mentako-ya/magictrackrest-qmk/mtr/mtr_image/key_image1.jpg

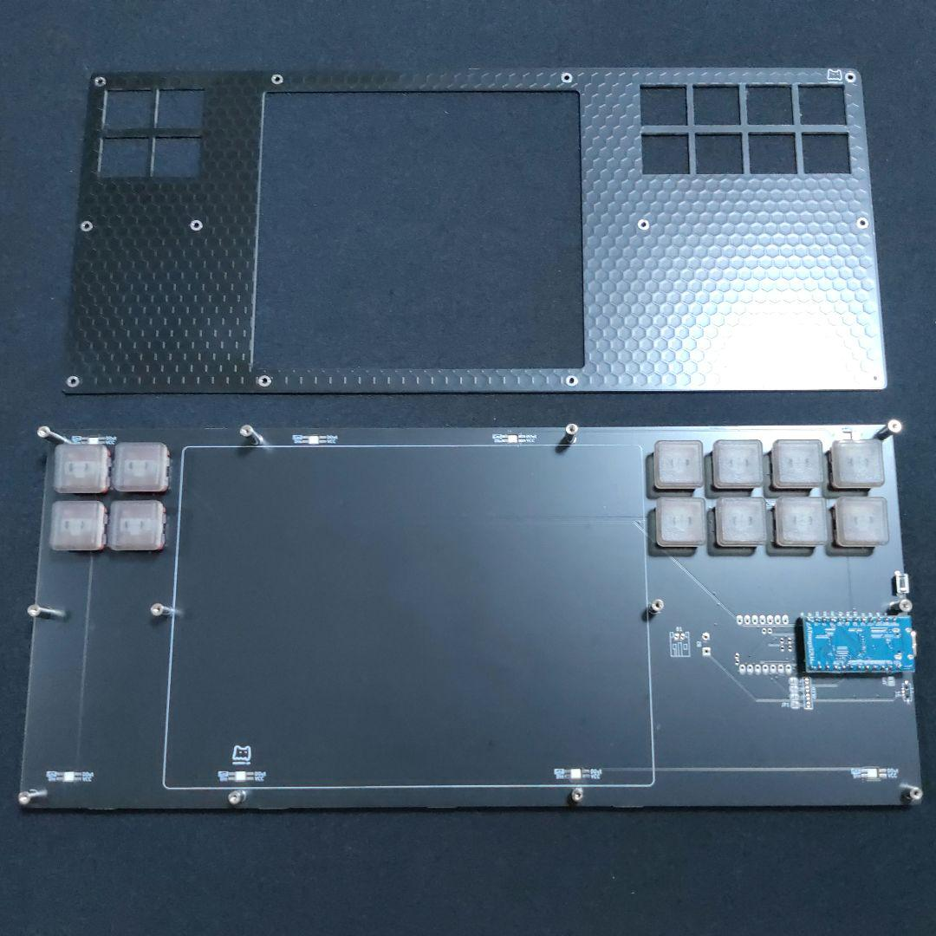
mtr/mtr_image/key_image1.jpg
