mentako-ya/magictrackrest-qmk/mtr/mtr_image/key_image2.jpg

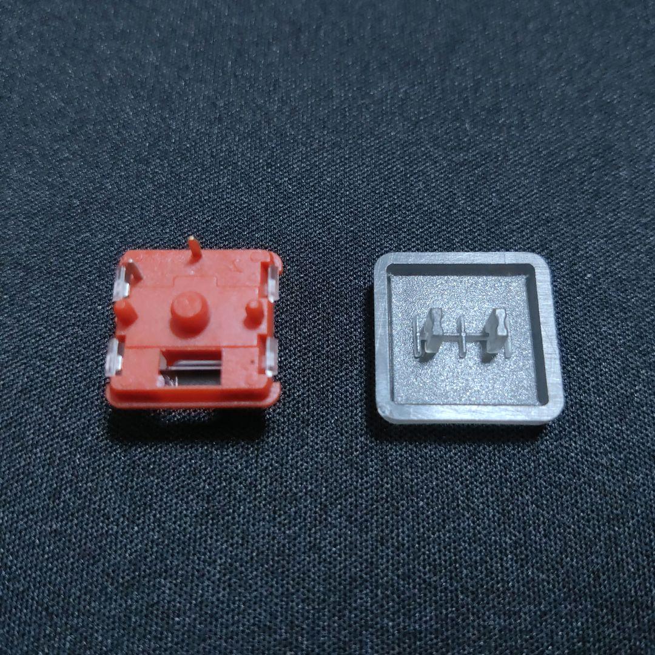
mtr/mtr_image/key_image2.jpg
