mentako-ya/magictrackrest-qmk/mtr/mtr_image/key_image3.jpg

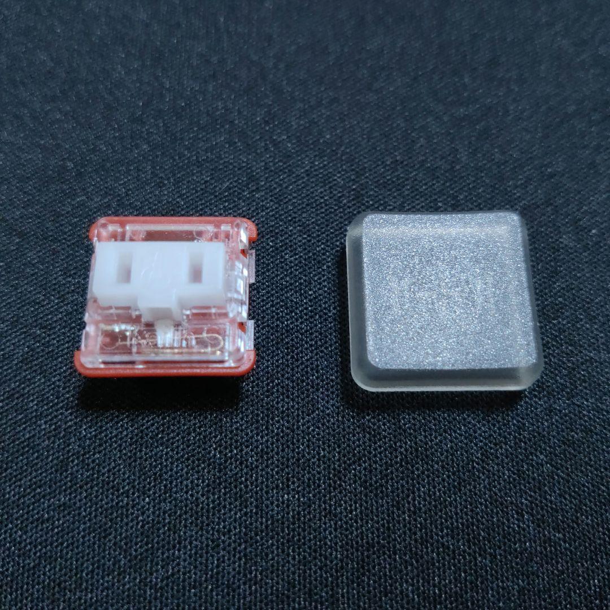
mtr/mtr_image/key_image3.jpg
