mentako-ya/magictrackrest-qmk/mtr/mtr_image/key_image4.jpg

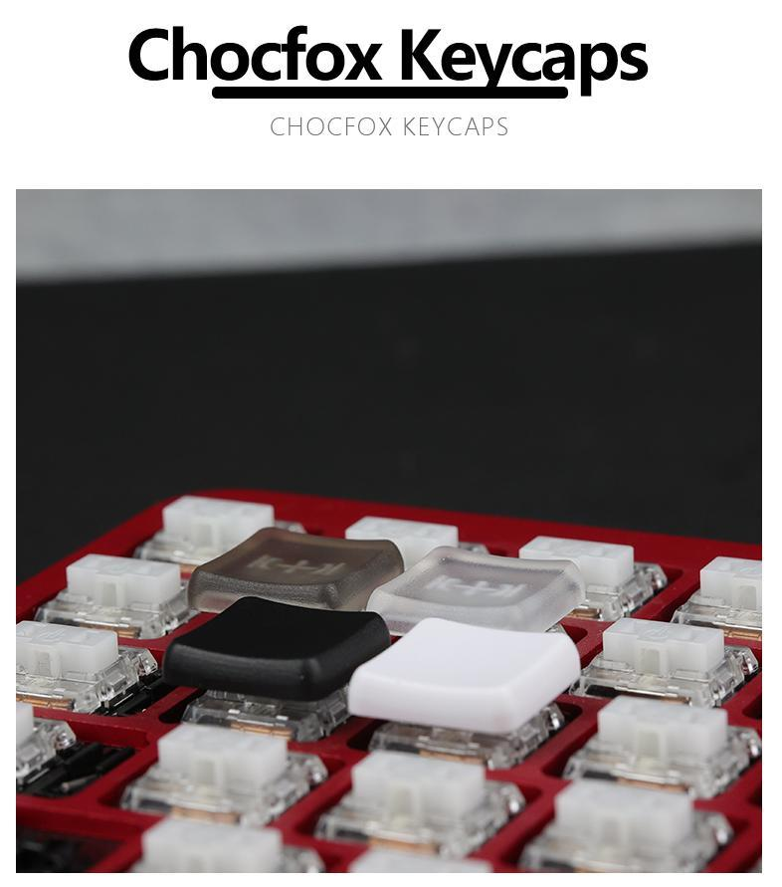
mtr/mtr_image/key_image4.jpg
