mentako-ya/magictrackrest-qmk/mtr/mtr_image/key_image5.jpg

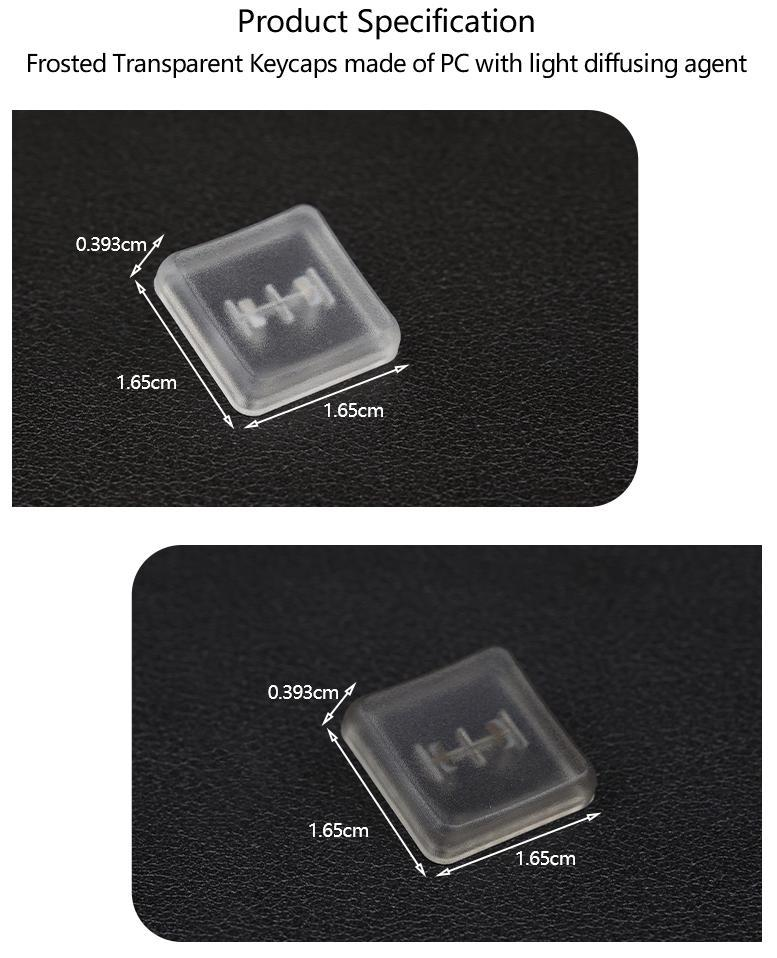
mtr/mtr_image/key_image5.jpg
