mentako-ya/magictrackrest-qmk/mtr/remap_image/remap_5.png

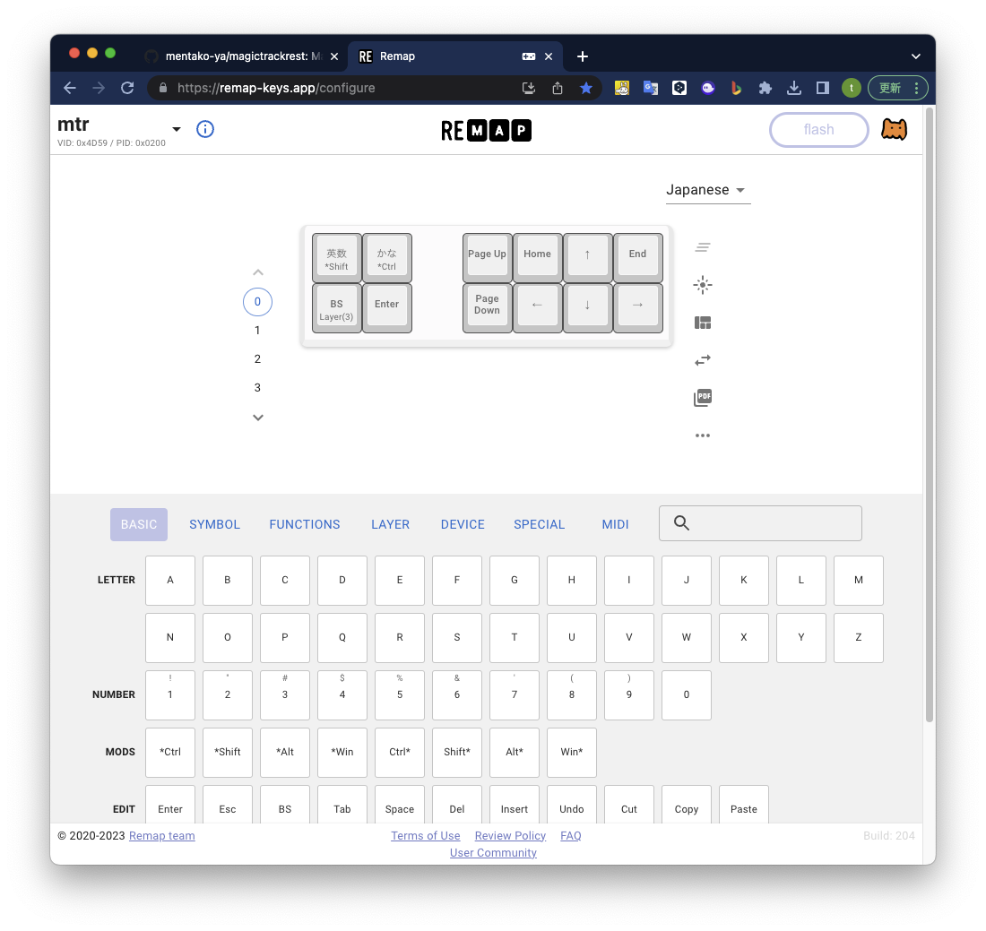
mtr/remap_image/remap_5.png
