mentako-ya/magictrackrest-qmk/buildguide/magictrackrest.pdf

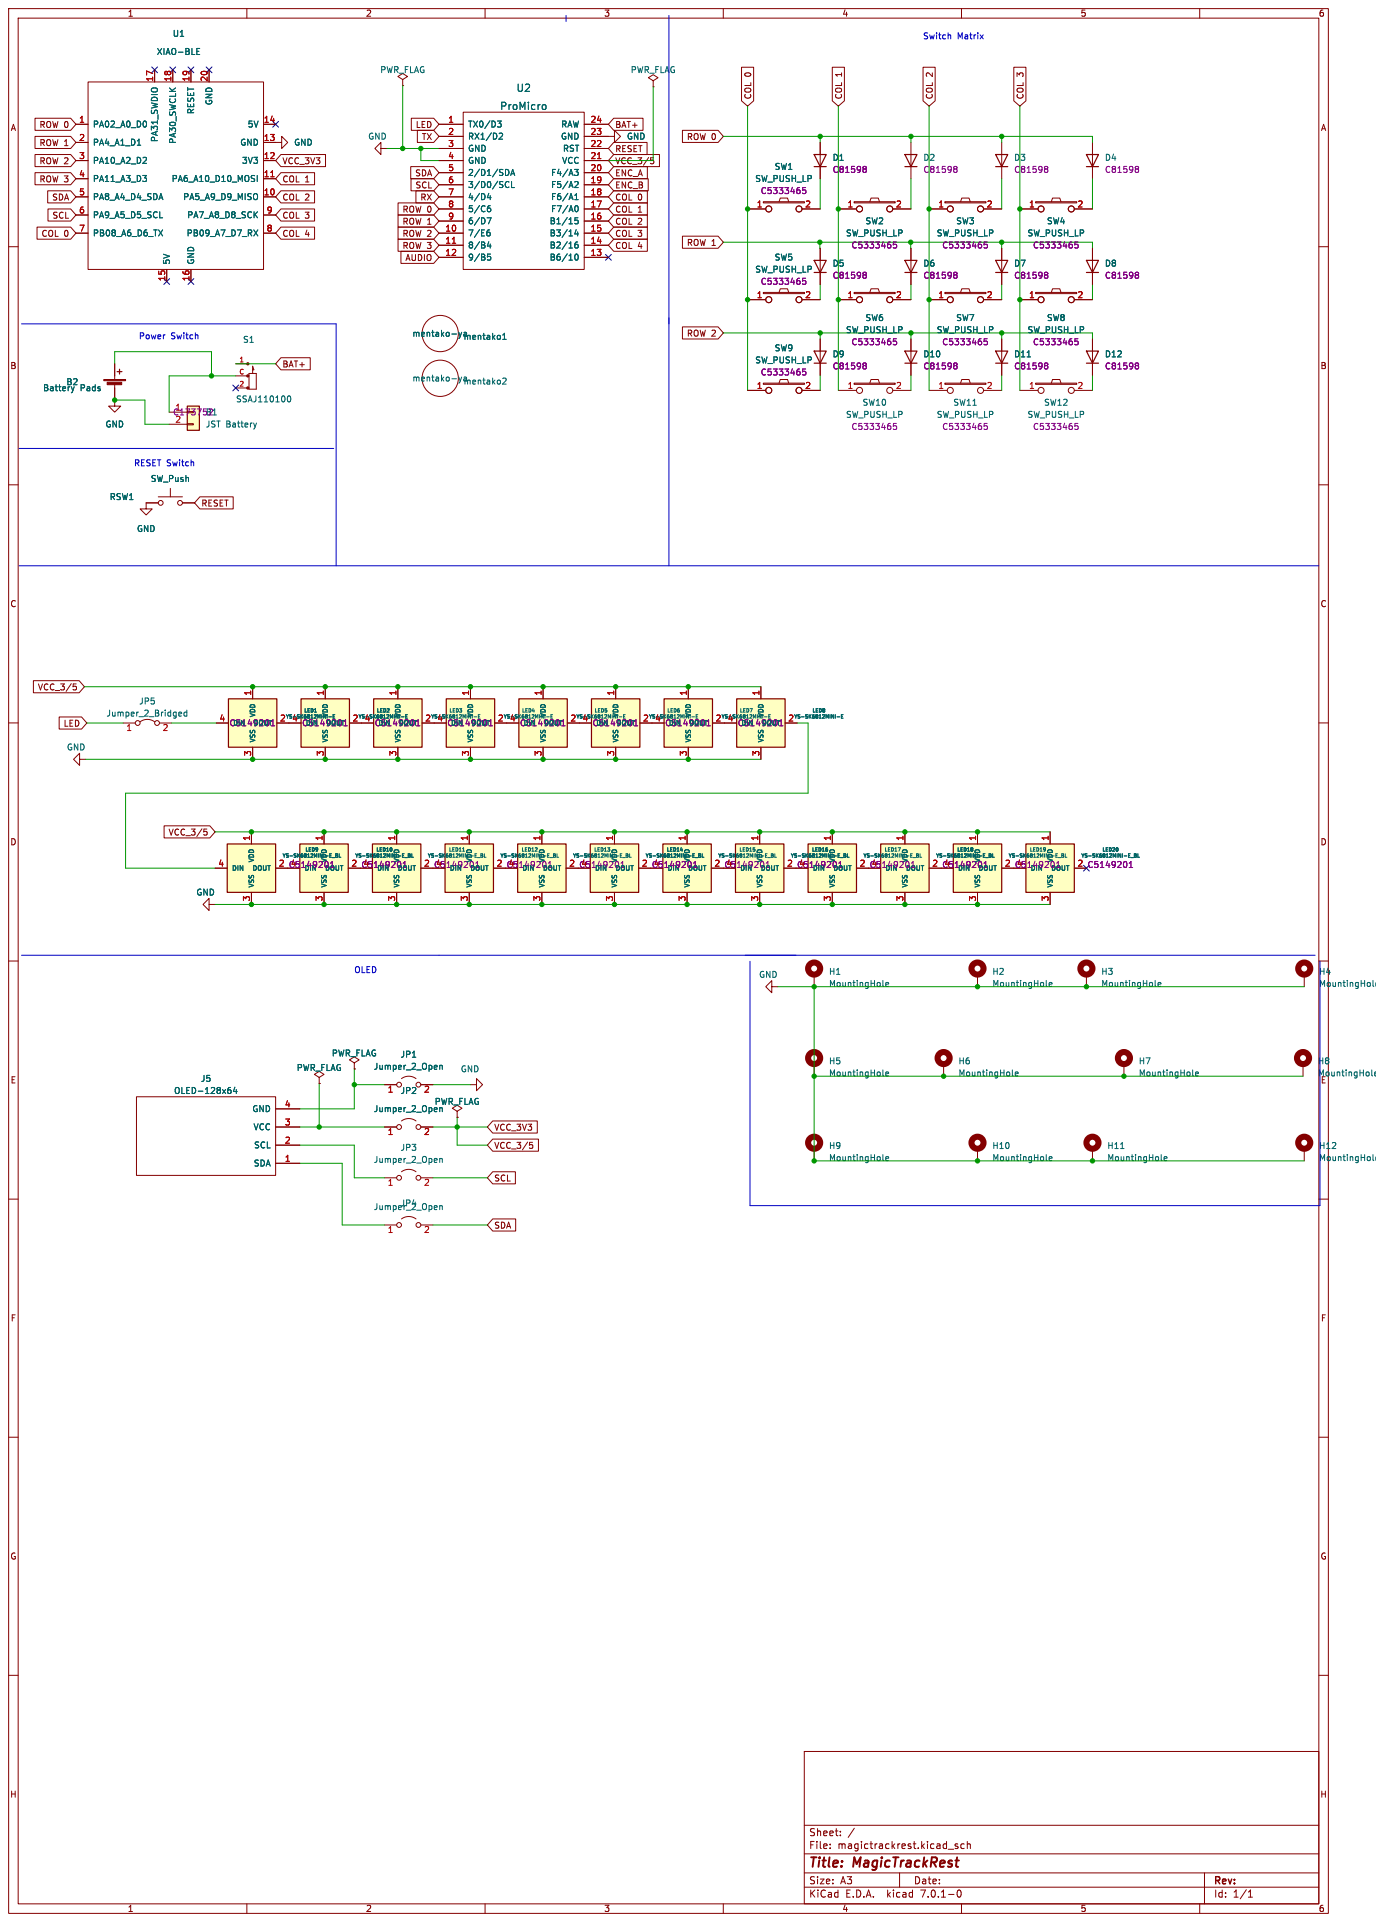
[picture p60: page 1]

SCL COL 0 SDA ROW 3 ROW 2 ROW 1 ROW 0

COL 2 COL 3 COL 4 COL 1

Power Switch RESET Switch

1 DOUT 2 VSS 3 DIN 4 GND

Id: 1/1 Title: MagicTrackRest File: magictrackrest.kicad_sch Sheet: /
