mentako-ya/magictrackrest-qmk/mtr/remap_image/keymap_cheatsheet_mtr_cursor_mouse_media.pdf

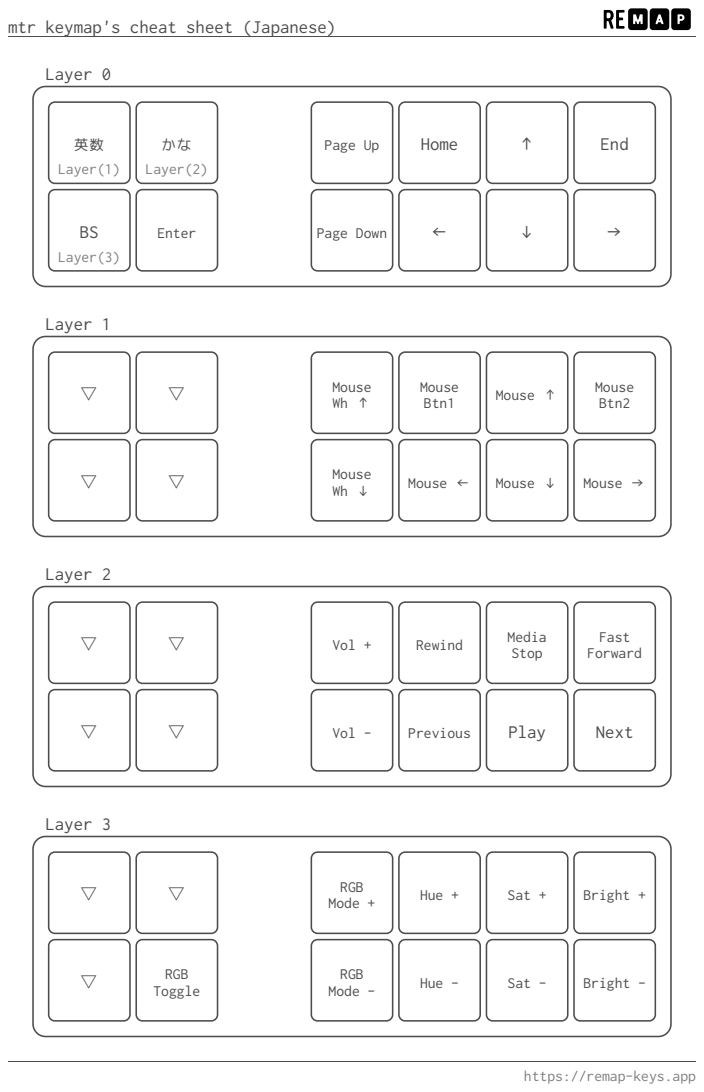
[picture p61: page 1]
Layer 0; 英数 Layer(1); かな Layer(2); Page Up; Home; End; Layer(3); Enter; Page Down; Layer 1; Mouse; Btn1; Mouse ↑; Btn2; Mouse ←; Mouse ↓; Mouse →; Layer 2; Vol +; Rewind; Media; Stop; Fast Forward; Vol -; Previous; Play; Next; Layer 3; RGB; Mode +; Hue +; Sat +; Bright +; Toggle; Mode -; Hue -; Sat -; Bright -

mtr keymap's cheat sheet (Japanese)

https://remap-keys.app
