mentako-ya/magictrackrest-qmk/mtr/remap_image/keymap_cheatsheet_mtr_cursor_shift_ctrl.pdf

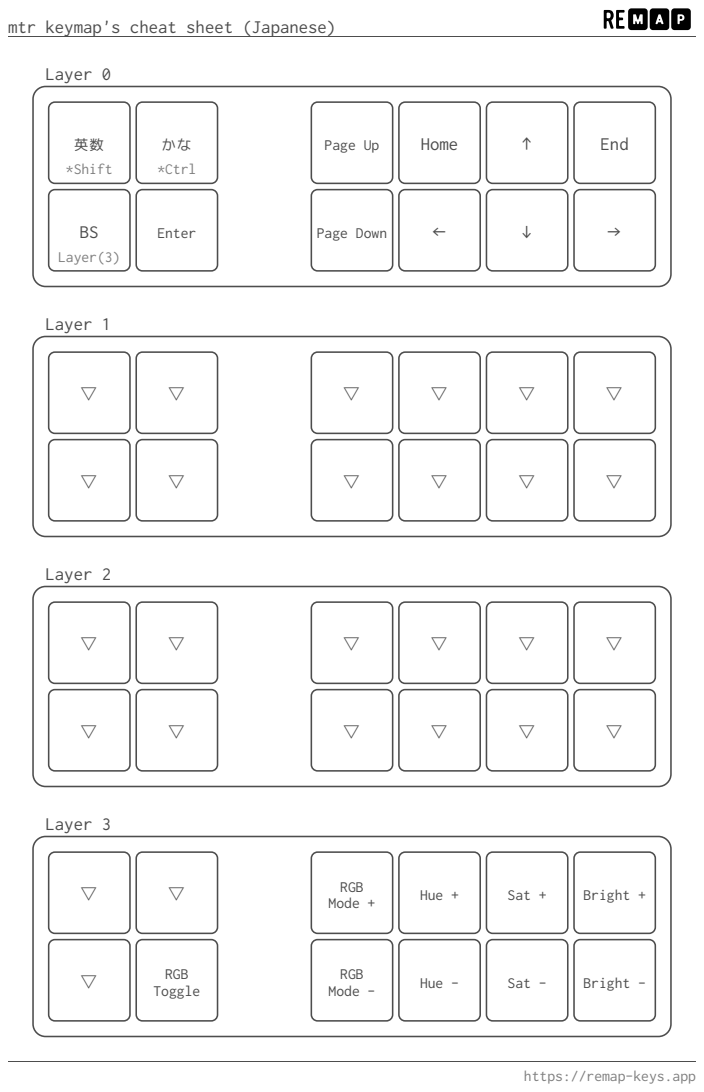
[picture p62: page 1]
Layer 0; 英数 *Shift; かな *Ctrl; Page Up; Home; End; Layer(3); Enter; Page Down; Layer 1; Layer 2; Layer 3; RGB; Mode +; Hue +; Sat +; Bright +; Toggle; Mode -; Hue -; Sat -; Bright -

mtr keymap's cheat sheet (Japanese)

https://remap-keys.app
