mentako-ya/magictrackrest-qmk/(commit log)

2023-05-06 初期コミット
2023-05-07 マトリクス、キーマップ、LED追加
2023-05-10 基本動作可
2023-05-11 OLED ロゴ表示
2023-05-13 VIA対応
2023-05-13 mentakoyaフォルダに移動
2023-05-31 ファームウェア、Remap用Jsonファイル作成
2023-05-31 回路図追加
